4T-tech/4T_L02/(list of files, cad)

Other CAD files:
[2]综合测试例程/TEST_U1/TEST_U1/Objects/main.obj
[2]综合测试例程/TEST_U2/TEST_U2/Objects/main.obj
[2]综合测试例程/TEST_U2/TEST_U2/Objects/iic.obj
[2]综合测试例程/TEST_U1/TEST_U1/Objects/STARTUP.obj
[2]综合测试例程/TEST_U2/TEST_U2/Objects/ds1302.obj
[2]综合测试例程/TEST_U2/TEST_U2/Objects/pcf8591.obj
[2]综合测试例程/TEST_U2/TEST_U2/Objects/STARTUP.obj
[2]综合测试例程/TEST_U2/TEST_U2/Objects/at24c02.obj
[2]综合测试例程/TEST_U2/TEST_U2/Objects/ds18b20.obj
